Tapendra-195/Hyper-K-Cable/README.md

Hyper-K cable potting instructions.
# 3D Model
* Contains the 3D model of a cap used to protect the connector when the cable is stored.

# Cable Potting Instructions.pdf
* Contains Hyper-K cable potting instructions.
