Tapendra-195/Hyper-K-Cable/(list of files, cad)

Other CAD files:
3DModels/Red_Outer_Sleeve.ipt
3DModels/Red_Outer_Sleeve_Closed.ipt
3DModels/SubConnectorFemale.ipt
