Tapendra-195/Hyper-K-Cable/Cable Potting Instructions.pdf

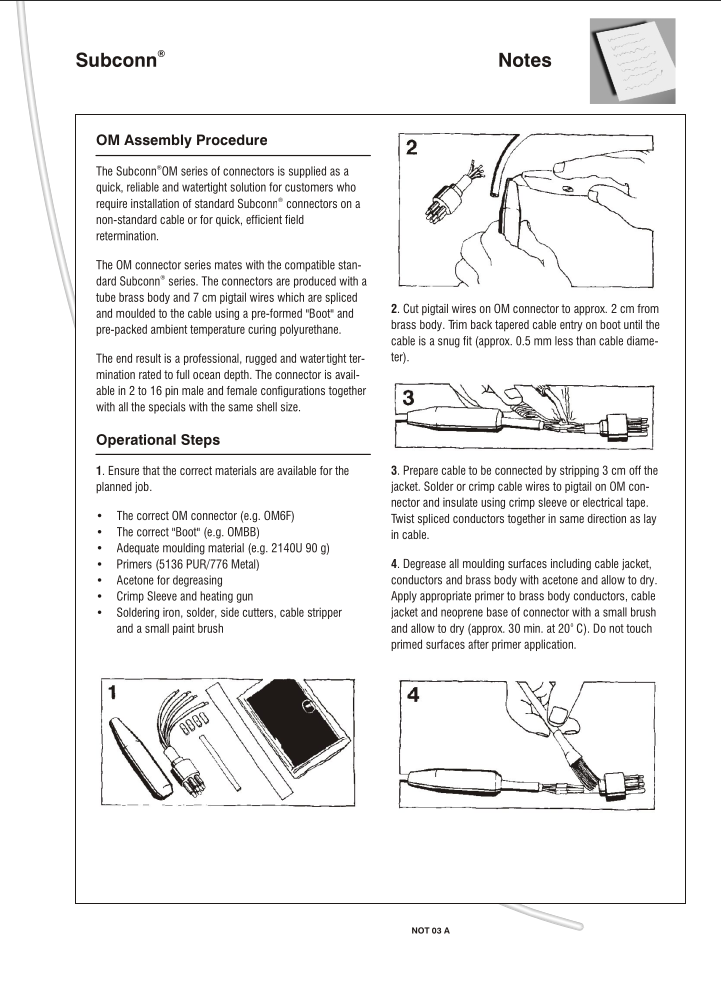
[picture p8: page 9]
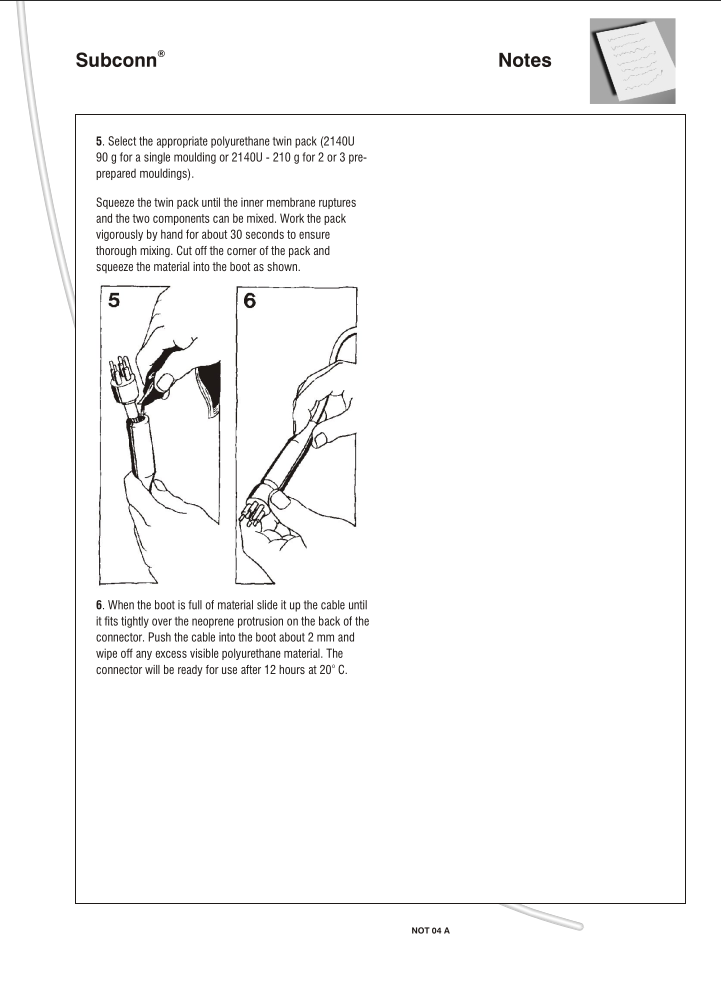
[picture p9: page 10]
