Tapendra-195/Hyper-K-Cable/Cable Potting Instructions.pdf

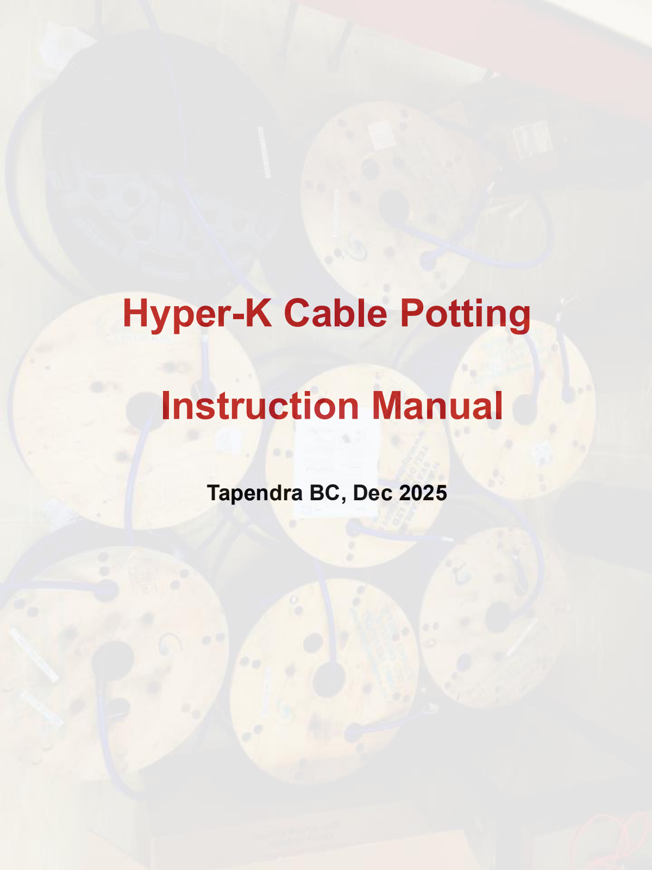
[picture p1: page 1]

# Hyper-K Cable Potting

# Instruction Manual

Tapendra BC, Dec 2025

# Materials Used:

1. Hydro group's cables
2. Weicon Primer P 400
3. 3M Scotchcast Flame-retardant compound 2131
4. MacArtney connector and boot
5. Acetone for degreasing.
6. 60 ml Luer lock syringe
7. 1/8'' ID , 3/16 OD vinyl tube
8. Aluminum tape
9. Custom made potting fixture

Review the Safety Data Sheets (SDS) for 3M 2131 Part A, Part B, and the primer before beginning the potting process.

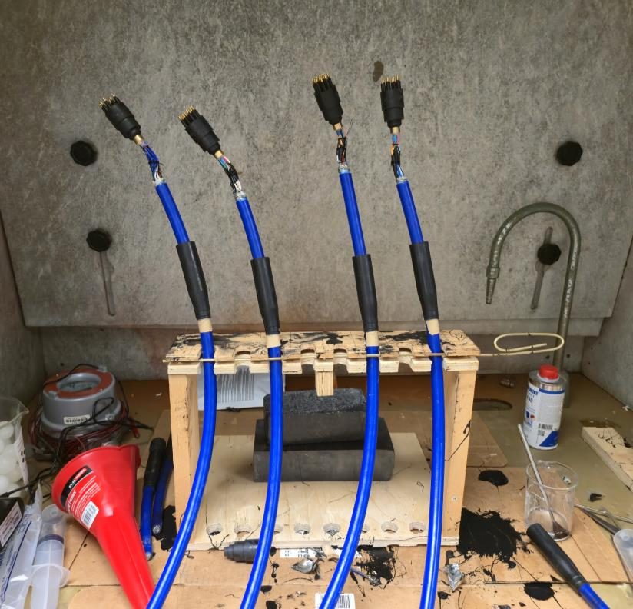
[picture p2: figure]

Fig: Potting fixture

# Cable Preparation:

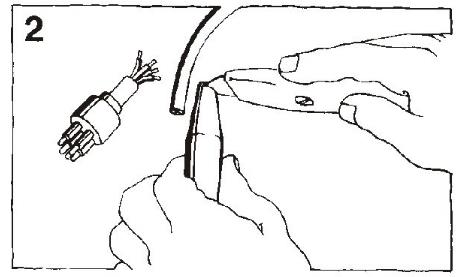
[picture p3: figure]

1. Trim the tapered cable entry on the boot until the cable fits snugly (approximately 0.5 mm smaller than the cable diameter).
2. Insert a piece of aluminum tape between the boot and the cable to reduce friction and allow the boot to slide easily. Place the metal side of the tape against the cable.
3. Cut the pigtail wires on the OM connector to approximately 2 cm from the brass body.
4. Prepare the cable by stripping 3 cm of the outer jacket. Solder the cable conductors to the OM connector pigtail wires and insulate the joints using heat-shrink tubing.

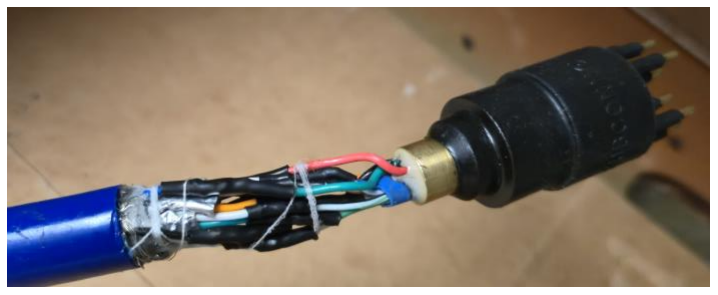
[picture p4: figure]

5. Wrap a thread around the wires to hold them together during the potting process.
6. Degrease all moulding surfaces—including the cable jacket, conductors, and brass body—using acetone and allow them to dry. Apply the weicon primer to the brass body, conductors, cable jacket, and neoprene base of the connector using a small brush. Allow the primer to dry for approximately 30 minutes at 20 °C. Do not touch primed surfaces after application.

# Resin Applicator Preparation:

According to the datasheet for 3M Scotchcast Flame-Retardant Compound 2131, the specified gel time is 17 minutes; however, in practice, the effective working time is less than 10 minutes. This means the compound remains in a liquid, flowable state for under 10 minutes, requiring the boots to be filled promptly.

Due to the bulkiness of the cables and the minimal clearance between the cable and the boot, it is not practical to fill more than one boot by pouring directly from the bag, as suggested in MacArtney’s FSK instructions. Instead, a syringe with vinyl tubing was used to inject the compound into the boots before the material began to gel.

1. Cut a vinyl tube to a length of 8 cm and press it onto the Luerlock tip of the syringe. Friction will hold the tubing in place.
2. Drill a 9/64 in. hole in the syringe barrel to allow air to vent.

## Prepare the syringe:

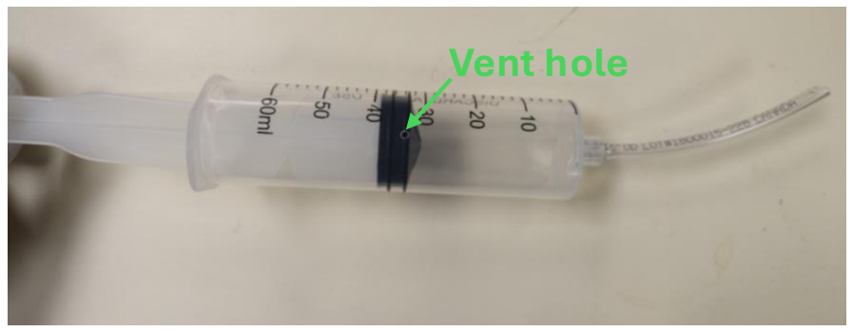
[picture p5: figure]
Vent hole

# Resin Preparation:

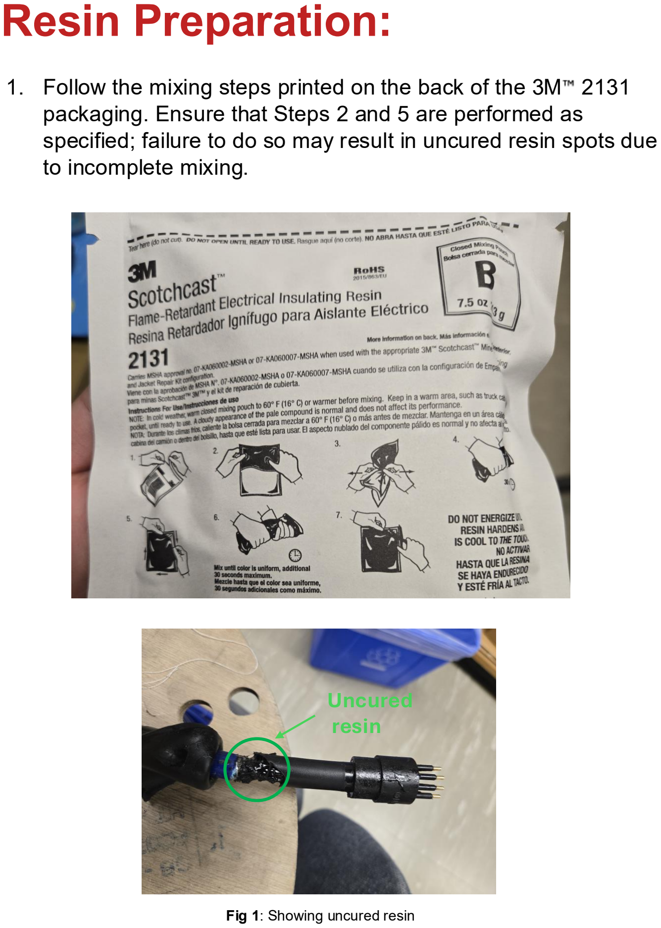
[picture p6: page 5]

1. Follow the mixing steps printed on the back of the 3M 2131 packaging. Ensure that Steps 2 and 5 are performed as specified; failure to do so may result in uncured resin spots due to incomplete mixing.

## Uncured resin

Fig 1: Showing uncured resin

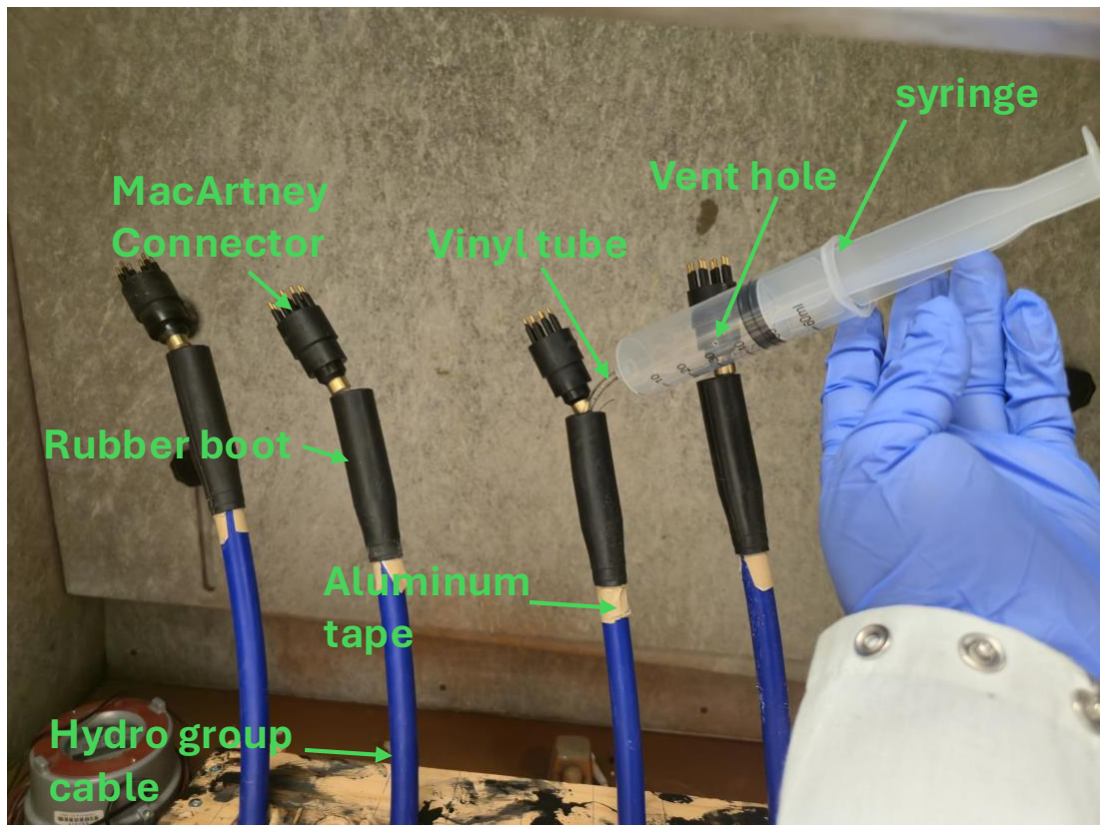
[picture p7: figure]
syringe; Vent hole; Vinyl tube; Aluminum tape; Hydro group cable; Rubber boot; MacArtney Connector

1. Remove the syringe plunger and pour the mixed resin into the syringe up to the drilled vent hole.
2. Reinsert the plunger and slowly push it up to the vent hole to expel air. Continue pushing past the hole until resin no longer leaks from the vent and begins to flow from the vinyl tube.
3. Insert the vinyl tube into the boot, as shown in the figure, and fill the boot with resin. Up to four boots can be filled in one go .
4. Allow the resin to settle before topping off the boot and closing it.
5. Remove the aluminum tape, then allow the resin to cure for 24 hours.

Fig 2: Demonstrating potting. The syringe is not filled with the compound in this picture, but it should be.

# References :

1. MacArtney FSK kit instruction, https://www.macartney.com/connectivity/subconn/subconnadditional (https://www.macartney.com/connectivity/subconn/subconn-additional-accessories/fsk-kit/)- (https://www.macartney.com/connectivity/subconn/subconn-additional-accessories/fsk-kit/)accessories/fsk (https://www.macartney.com/connectivity/subconn/subconn-additional-accessories/fsk-kit/)- (https://www.macartney.com/connectivity/subconn/subconn-additional-accessories/fsk-kit/)kit/ (https://www.macartney.com/connectivity/subconn/subconn-additional-accessories/fsk-kit/)
2. 3M 2131 datasheet,
https://multimedia.3m.com/mws/media/719642O/microsoftword-78-8129-9502-1-rev-d-docx.pdf

# Appendix
